xiangxu05/tensileMachine/Peel tension V4/伺服推杆/伺服电动缸 2700/877bbd0834424bce7f686309f9e86cf.jpg

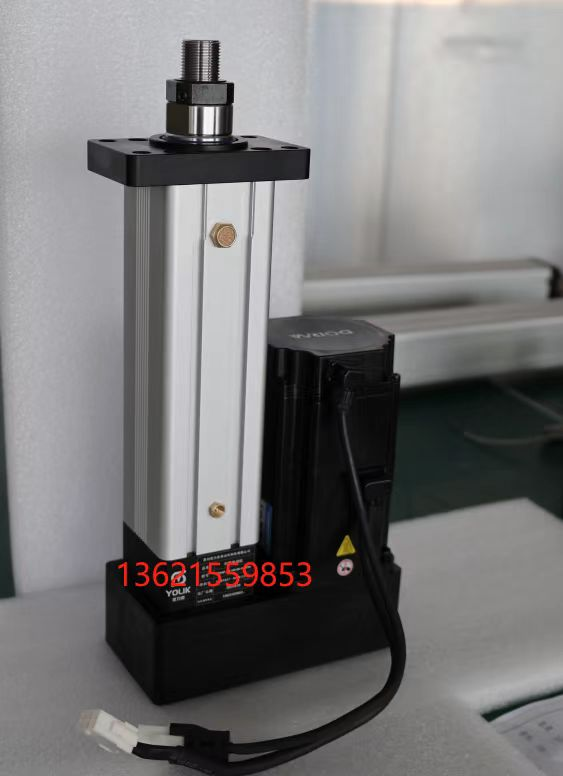
Peel tension V4/伺服推杆/伺服电动缸 2700/877bbd0834424bce7f686309f9e86cf.jpg
