xiangxu05/tensileMachine/Peel tension V4/伺服推杆/A伺服电缸 2850/苏州源鸿星伺服电缸报价-伺服电机-后法兰-YHX053-S150-项总10.18.pdf

苏州源鸿星自动化科技有限公司

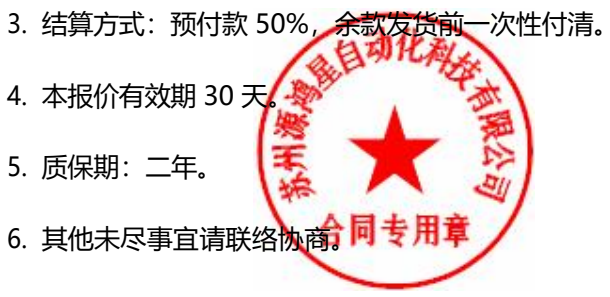
[picture p2: figure]
3. 结算方式：预付款 50%，余款发货前一次性付清。; 4. 本报价有效期 30 天。; 5. 质保期：二年。; 6. 其他未尽事宜请联络协商。

第 1 页 共 4页

## 苏州源鸿星自动化科技有限公司

## 报价单

### 客户名称：

### 联系人：项总

### 报价项目：伺服电缸

电话：15905903975

联系人：王远团 | 电话：18944282776

### 地址：江苏省苏州市吴中区

序号 | 产品名称 | 产品规格 | 单位 | 数量 | 单价 | 小计 | 品牌
2 | 电缸 | YHX053-S150-D05-B-M4C1-2-0400W-N1 | Pcs | 1 | 1500 | 1500 | 源鸿星
| 伺服电机 | 400W电机（带抱闸）+伺服驱动器 485通 讯 | PCS | 1 | 1350 | 1350 | 信捷
| 磁性开关 | DFSE-020-8C（赠送） | PCS | 2 | 0.00 | 0.00 | 元利富
技术参数:
配400W电机（带抱闸）+伺服驱动器，扭矩:1.27N.M., 额定转速:3000RPM, 减速比：1:1； 额定推力：100KG， 速度：0-250MM/S可调，有效行程：0-150mm(可调）;电机安装方式：折返，电缸安装方式：后法兰， 负载连接 方式：外螺纹， 丝杆规格：TBI1205
合计 RMB | 贰仟捌佰伍拾圆整 | 2850.00

### 1. 交货期：预付款到 5个工作日内交货（如需加急，需沟通确认）。

### 2. 价格条款：以上报价含13%增值税发票，运费由卖方承担。

苏州源鸿星自动化科技有限公司

第 2 页 共 4页

2023.10.18

## 请确认报价和参数是否满足您的需求，确认无误安排给您出尺寸图二维或者三维。

1 | 型号 | YHX053-S150-D05-B-M4C1-2-0400W-N1
2 | 外形图号 | | 见图纸
3 | 电机安装方式 | 折返
4 | 丝杆规格（mm） | TBI1205 | 滚珠丝杆/TBI
5 | 轴承 | 角接触轴承 推力滚子轴承 | 日本/NSK
6 | 有效行程（mm） | 0-150mm可调 | 注;外部紧固件采用镀镍螺钉和弹垫
7 | 最大行程（mm） | 155mm
8 | 额定推力（KN） | 100KG
9 | 额定速度（mm/s） | 0-250MM/S可调 | 速度可在（0-250mm/s）额定速度范围内 调节
10 | 重复定位精度(mm) | +/-0.02mm
11 | 电机型号 | MS6H-60CS30BZ1-20P4
12 | 驱动器型号 | DS5L1-20P4-PTA
13 | 电机额定功率（KW） | 400W
14 | 电机额定转速（rpm） | 3000RPM
15 | 减速比 | 1:1
16 | 内部防转机构 | 有 | 上银
17 | 限位开关 | 有 | 2 个极限（NPN 常开)
19 | 润滑方式 | 润滑油 | 标准锂基润滑脂 3 号，特殊环境请说明
20 | 电缸安装方式 | 后法兰
21 | 负载连接方式 | 外螺纹
