xiangxu05/tensileMachine/Peel tension V4/伺服推杆/伺服电动缸 2700/1cc9031d6b838c07ec88c5fcb92dcce.png

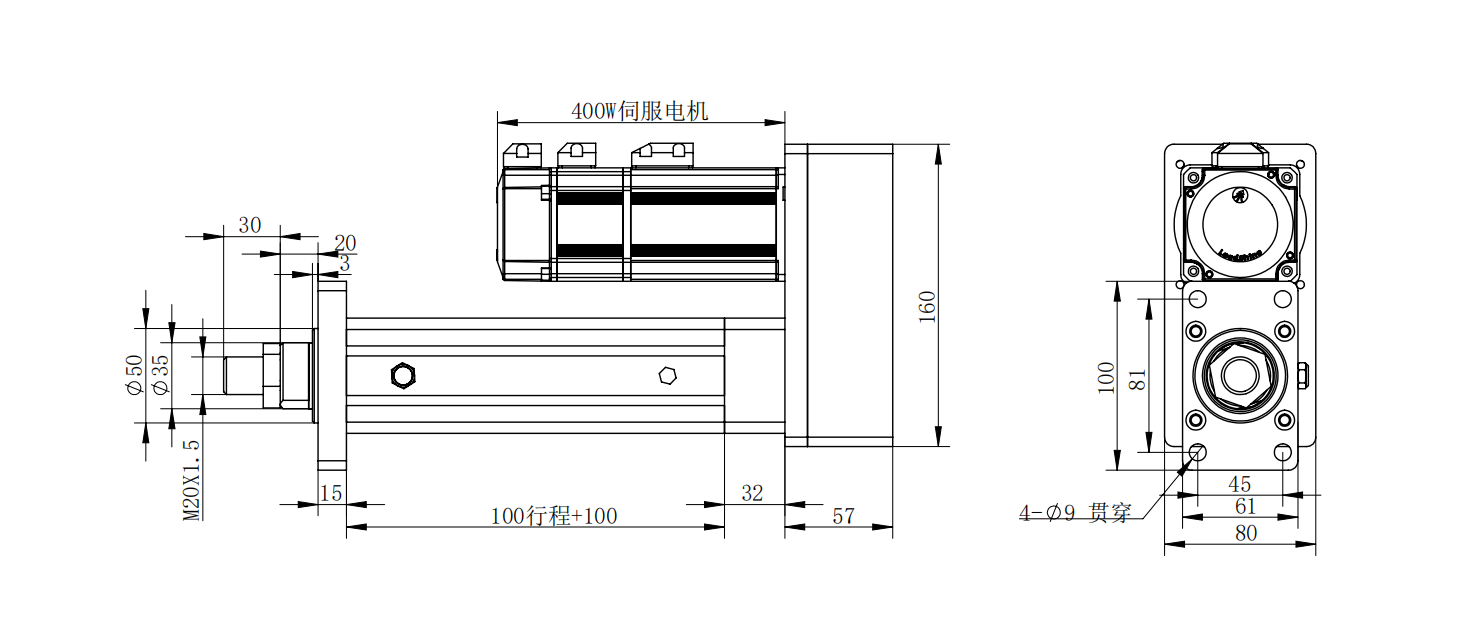
Peel tension V4/伺服推杆/伺服电动缸 2700/1cc9031d6b838c07ec88c5fcb92dcce.png
