xiangxu05/tensileMachine/Peel tension V4/电路板.SLDASM

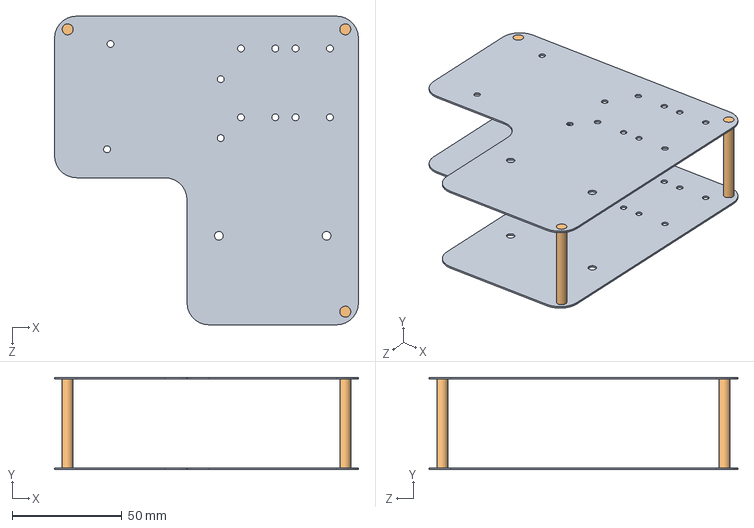
[picture p4: CAD file, 2024-04-22]
Peel tension V4/电路板.SLDASM
138.3 x 42.0 x 140.4 mm
电路板固定 x 2
柱子 x 3
