xiangxu05/tensileMachine/Peel tension V4/伺服推杆/道雨传动 3000/TDN55三维图/TDN55三维图/TDN55折返/TDN55折返行程700/负载连接端配件/BNC51-SA12T_K-R.SLDASM

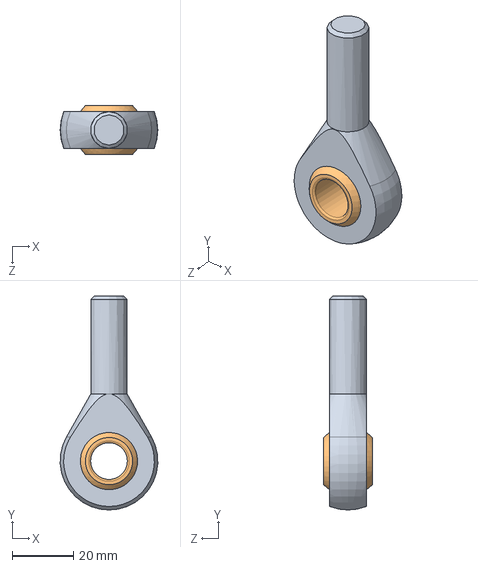
[picture p5: CAD file, 2024-04-22]
Peel tension V4/伺服推杆/道雨传动 3000/TDN55三维图/TDN55三维图/TDN55折返/TDN55折返行程700/负载连接端配件/BNC51-SA12T_K-R.SLDASM
31.9 x 70.0 x 16.0 mm
_BNC51-SA12T_K-R-001
_BNC51-SA12T_K-R-002
