xiangxu05/tensileMachine/Peel tension V4/伺服推杆.SLDASM

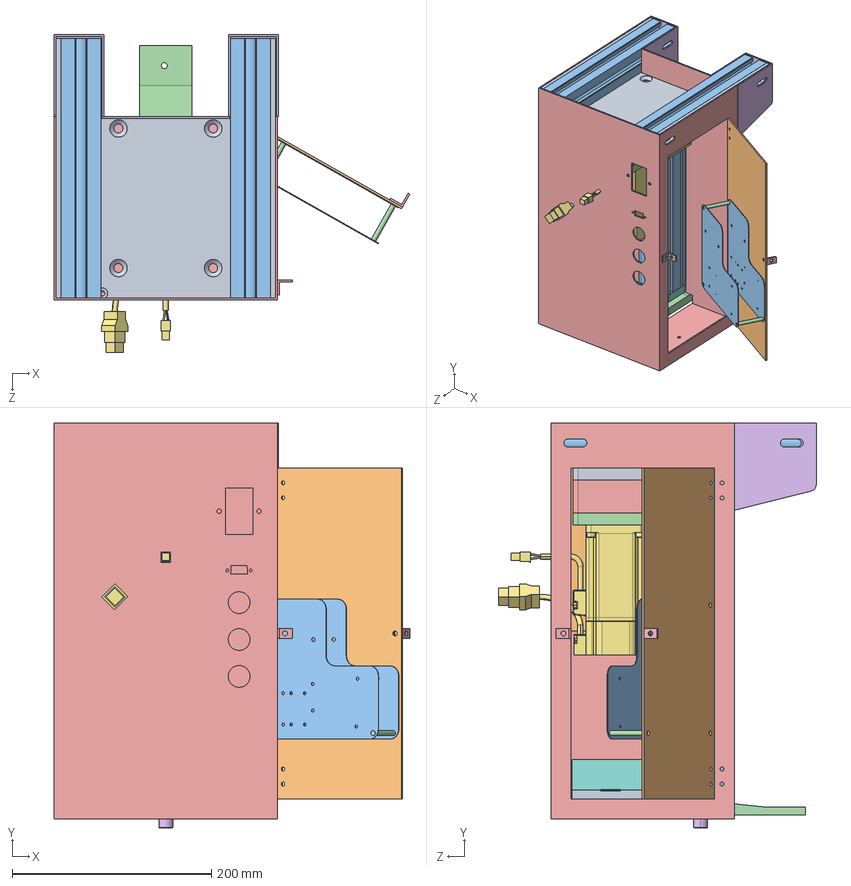
[picture p6: CAD file, 2024-04-22]
Peel tension V4/伺服推杆.SLDASM
356.7 x 406.1 x 318.4 mm
底板
53ZCZ.STEP
53GT.STEP
53LJB.STEP
53XT.STEP
M14X1.5.STEP
400W.STEP
53-QFL.STEP
53HFL.STEP
伺服驱动器
40x40x260 纵梁 x 2
顶板
外壳
外壳2 x 2
X505
down
top
外壳盖子
电路板固定 x 2
柱子 x 3
把手 x 2
