xiangxu05/tensileMachine/Peel tension V4/数模转换器固定/数模转换器固定.SLDASM

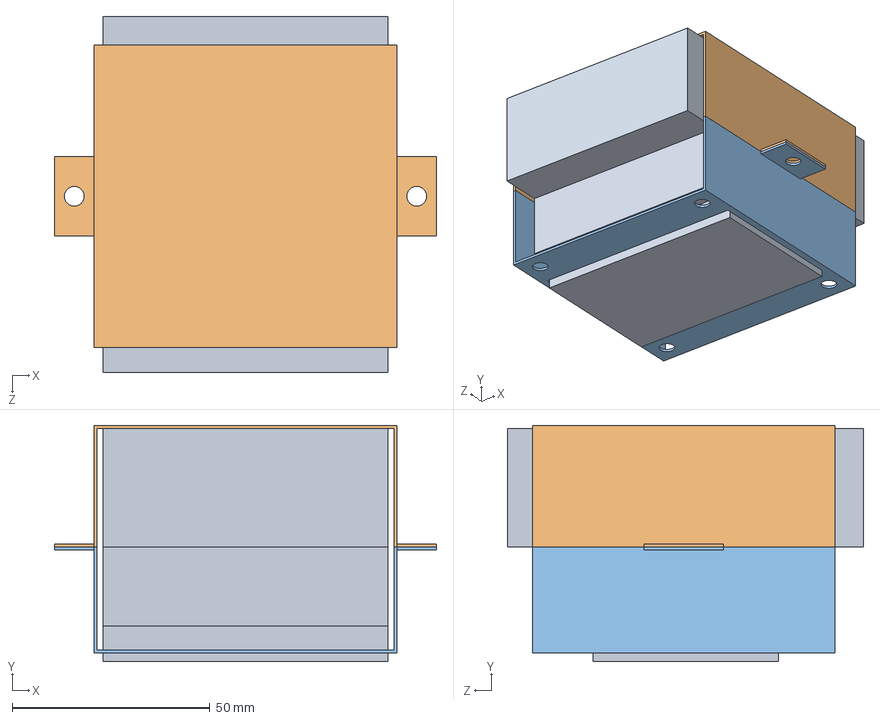
[picture p8: CAD file, 2024-04-22]
Peel tension V4/数模转换器固定/数模转换器固定.SLDASM
96.6 x 59.8 x 90.1 mm
X505
down
top
