xiangxu05/tensileMachine/Peel tension V4/外壳组装.SLDASM

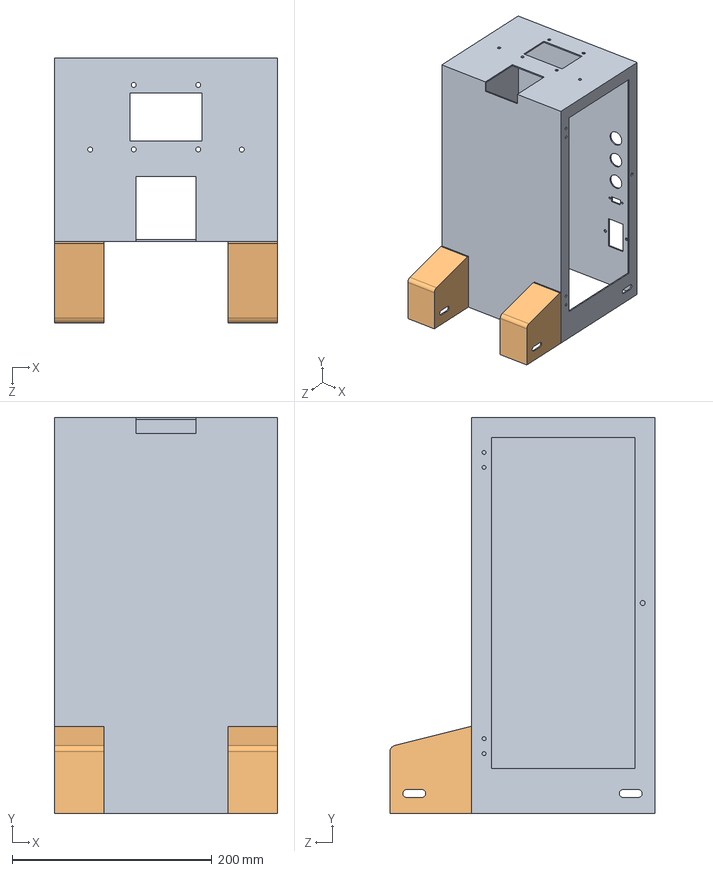
[picture p9: CAD file, 2024-04-22]
Peel tension V4/外壳组装.SLDASM
224.0 x 397.0 x 266.0 mm
外壳
外壳2 x 2
