xiangxu05/tensileMachine/Peel tension V4/装配体1.SLDASM

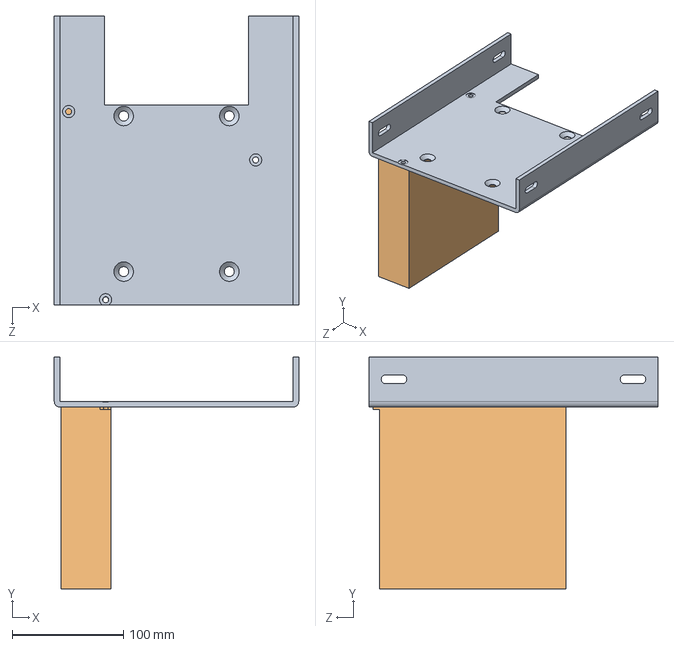
[picture p10: CAD file, 2024-04-22]
Peel tension V4/装配体1.SLDASM
220.0 x 208.6 x 260.0 mm
底板
伺服驱动器
