xiangxu05/tensileMachine/Peel tension V4/伺服推杆/道雨传动 3000/TDN55三维图/TDN55三维图/TDN55折返/TDN55折返行程100/推荐电机/信捷400W带刹车.STEP

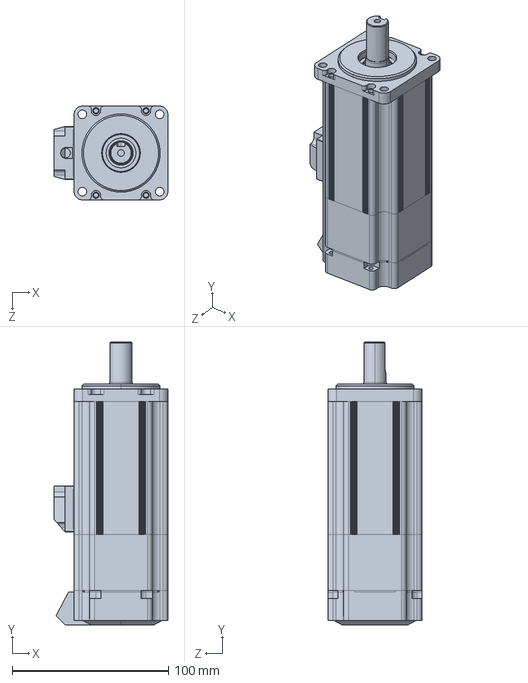
[picture p13: CAD file, 2024-04-22]
Peel tension V4/伺服推杆/道雨传动 3000/TDN55三维图/TDN55三维图/TDN55折返/TDN55折返行程100/推荐电机/信捷400W带刹车.STEP
72.8 x 181.0 x 60.0 mm
