xiangxu05/tensileMachine/Peel tension V4/伺服推杆/道雨传动 3000/TDN55三维图/TDN55三维图/TDN55折返/TDN55折返行程100/推荐行星减速机/PLF60A单级模型（14-30 50-3 4-5.5-70）.STEP

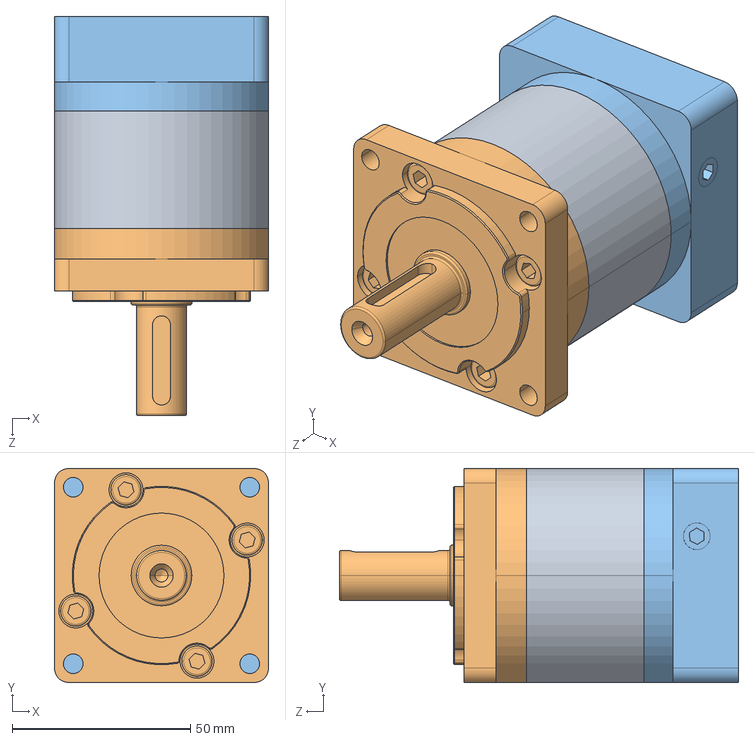
[picture p14: CAD file, 2024-04-22]
Peel tension V4/伺服推杆/道雨传动 3000/TDN55三维图/TDN55三维图/TDN55折返/TDN55折返行程100/推荐行星减速机/PLF60A单级模型（14-30 50-3 4-5.5-70）.STEP
60.0 x 60.0 x 112.0 mm
