xiangxu05/tensileMachine/Peel tension V4/伺服推杆/道雨传动 3000/TDN55三维图/TDN55三维图/TDN55折返/TDN55折返行程100/电缸安装配件/F-SI40TCM1_SE40耳轴铰座支架.stp

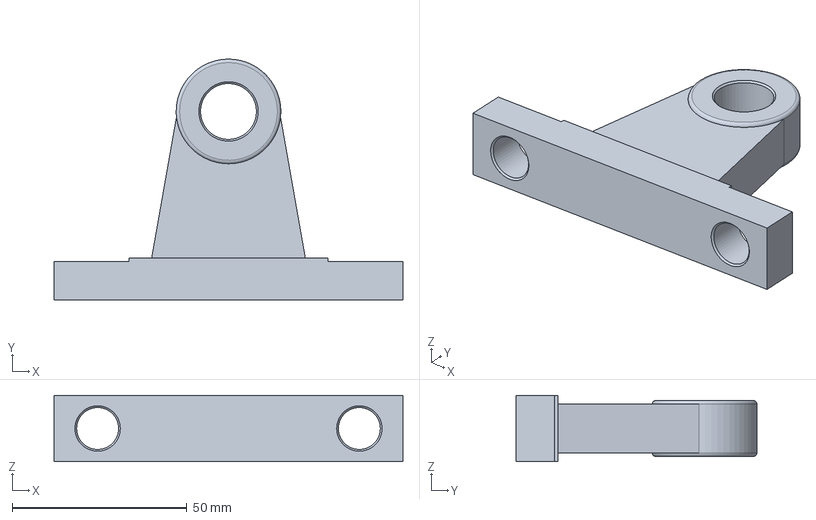
[picture p15: CAD file, 2024-04-22]
Peel tension V4/伺服推杆/道雨传动 3000/TDN55三维图/TDN55三维图/TDN55折返/TDN55折返行程100/电缸安装配件/F-SI40TCM1_SE40耳轴铰座支架.stp
100.0 x 69.0 x 19.0 mm
