xiangxu05/tensileMachine/Peel tension V4/伺服推杆/道雨传动 3000/TDN55三维图/TDN55三维图/TDN55折返/TDN55折返行程100/负载连接端配件/F-M12125Y型接头.stp

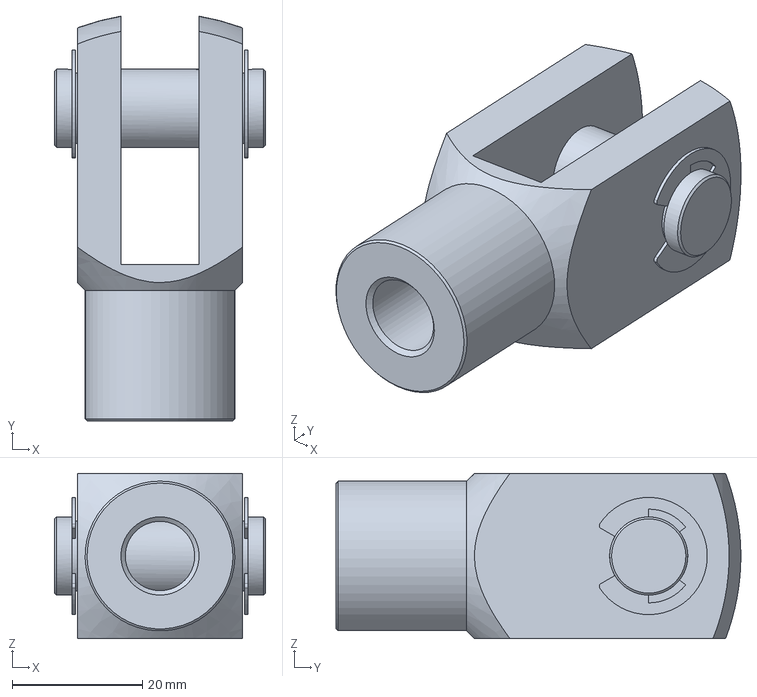
[picture p16: CAD file, 2024-04-22]
Peel tension V4/伺服推杆/道雨传动 3000/TDN55三维图/TDN55三维图/TDN55折返/TDN55折返行程100/负载连接端配件/F-M12125Y型接头.stp
32.4 x 62.1 x 25.4 mm
