xiangxu05/tensileMachine/Peel tension V4/伺服推杆/道雨传动 3000/TDN55三维图/TDN55三维图/TDN55折返/TDN55折返行程125/推荐电机/禾川400W带刹车.SLDPRT

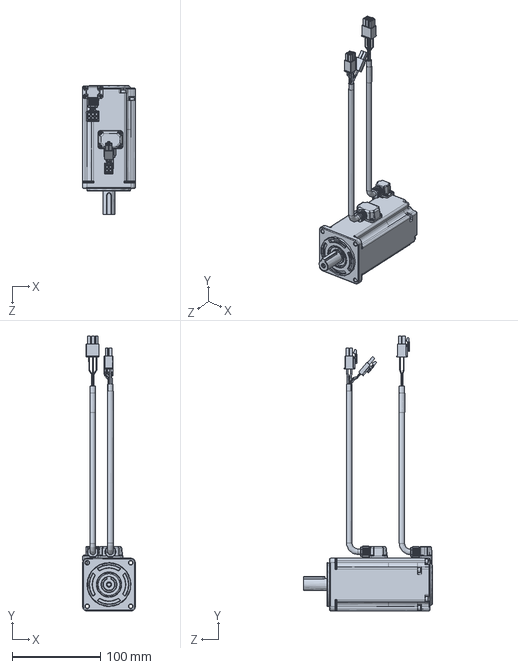
[picture p18: CAD file, 2024-04-22]
Peel tension V4/伺服推杆/道雨传动 3000/TDN55三维图/TDN55三维图/TDN55折返/TDN55折返行程125/推荐电机/禾川400W带刹车.SLDPRT
60.0 x 312.4 x 147.1 mm
