xiangxu05/tensileMachine/Peel tension V4/伺服推杆/道雨传动 3000/TDN55三维图/TDN55三维图/TDN55折返/TDN55折返行程125/电缸安装配件/F-SI40CR_SE斜耳铰座.stp

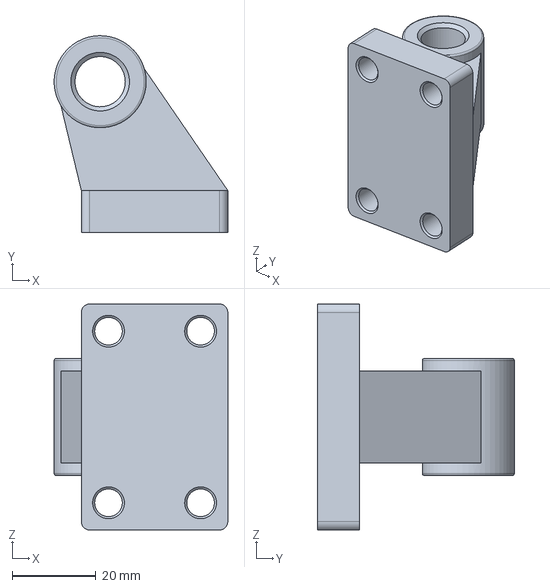
[picture p19: CAD file, 2024-04-22]
Peel tension V4/伺服推杆/道雨传动 3000/TDN55三维图/TDN55三维图/TDN55折返/TDN55折返行程125/电缸安装配件/F-SI40CR_SE斜耳铰座.stp
41.5 x 47.0 x 54.0 mm
