xiangxu05/tensileMachine/Peel tension V4/伺服推杆/道雨传动 3000/TDN55三维图/TDN55三维图/TDN55折返/TDN55折返行程125/负载连接端配件/F-M12X125I型接头.stp

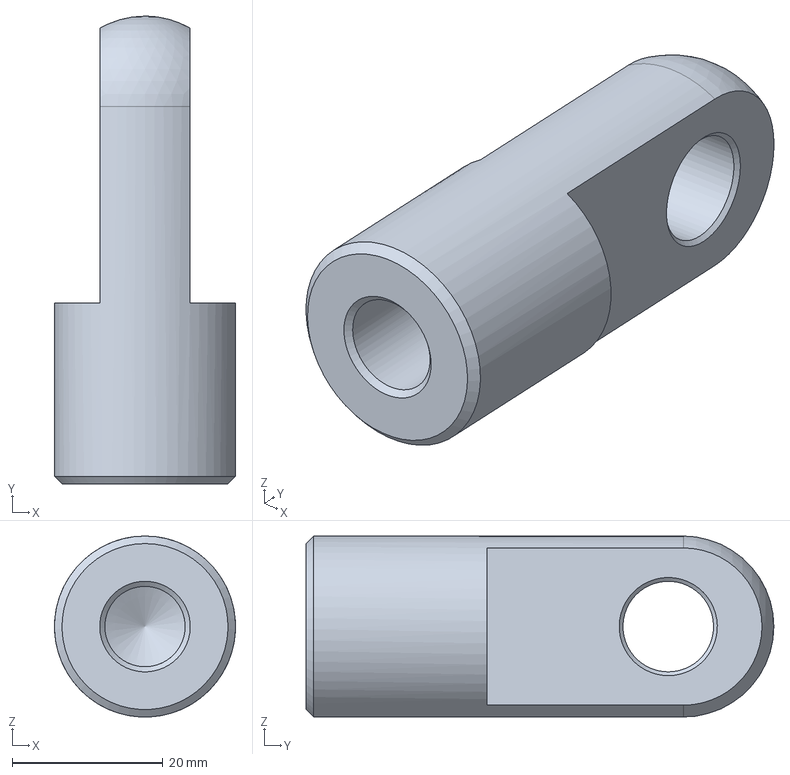
[picture p20: CAD file, 2024-04-22]
Peel tension V4/伺服推杆/道雨传动 3000/TDN55三维图/TDN55三维图/TDN55折返/TDN55折返行程125/负载连接端配件/F-M12X125I型接头.stp
24.0 x 62.0 x 24.0 mm
