xiangxu05/tensileMachine/Peel tension V4/伺服推杆/道雨传动 3000/TDN55三维图/TDN55三维图/TDN55折返/TDN55折返行程130/负载连接端配件/F-M12X125U鱼眼接头.stp

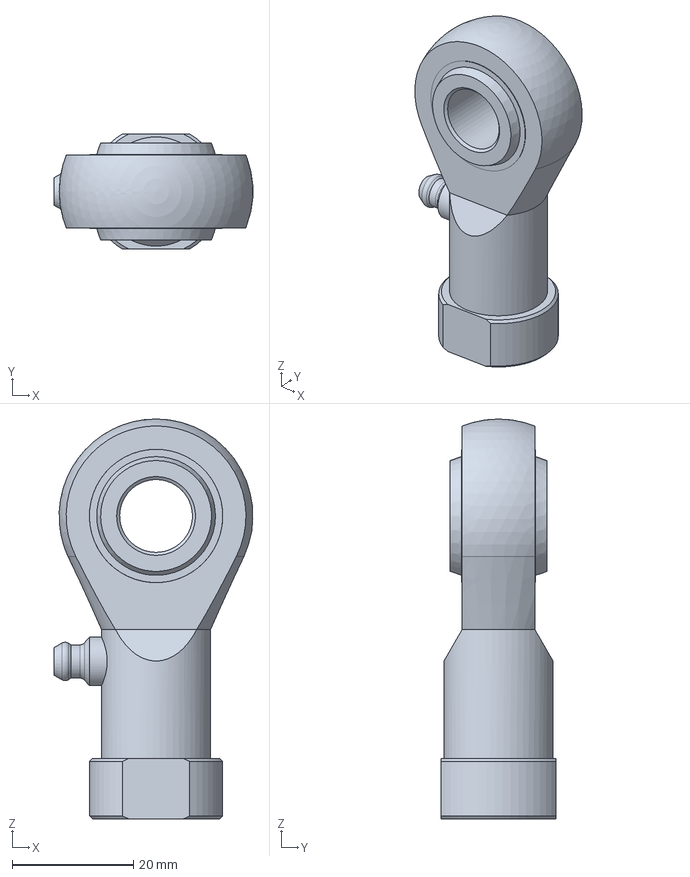
[picture p21: CAD file, 2024-04-22]
Peel tension V4/伺服推杆/道雨传动 3000/TDN55三维图/TDN55三维图/TDN55折返/TDN55折返行程130/负载连接端配件/F-M12X125U鱼眼接头.stp
32.8 x 19.0 x 66.0 mm
