xiangxu05/tensileMachine/Peel tension V4/伺服推杆/道雨传动 3000/TDN55三维图/TDN55三维图/TDN55折返/TDN55折返行程160/55缸折返基础版 - 160.STEP

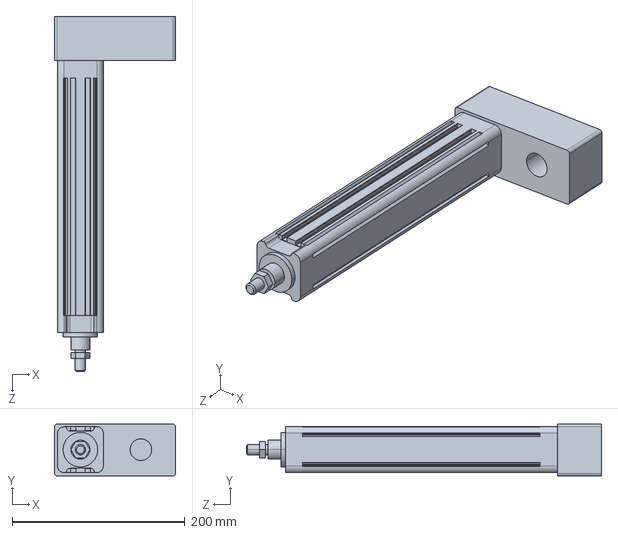
[picture p23: CAD file, 2024-04-22]
Peel tension V4/伺服推杆/道雨传动 3000/TDN55三维图/TDN55三维图/TDN55折返/TDN55折返行程160/55缸折返基础版 - 160.STEP
140.0 x 60.0 x 411.0 mm
