xiangxu05/tensileMachine/Peel tension V4/伺服推杆/道雨传动 3000/TDN55三维图/TDN55三维图/TDN55折返/TDN55折返行程160/电缸安装配件/F-SE40CB双耳铰座.stp

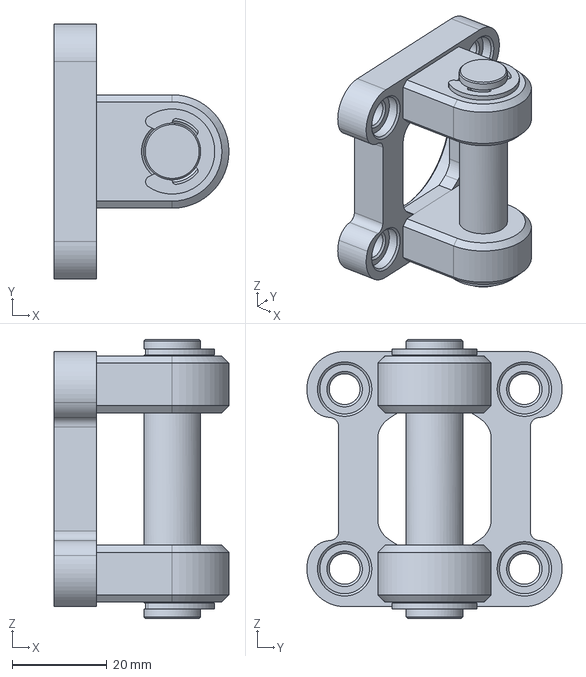
[picture p24: CAD file, 2024-04-22]
Peel tension V4/伺服推杆/道雨传动 3000/TDN55三维图/TDN55三维图/TDN55折返/TDN55折返行程160/电缸安装配件/F-SE40CB双耳铰座.stp
37.0 x 54.0 x 59.0 mm
