xiangxu05/tensileMachine/Peel tension V4/伺服推杆/道雨传动 3000/TDN55三维图/TDN55三维图/TDN55折返/TDN55折返行程170/电缸安装配件/F-SI40FTC_SE前耳轴铰座.stp

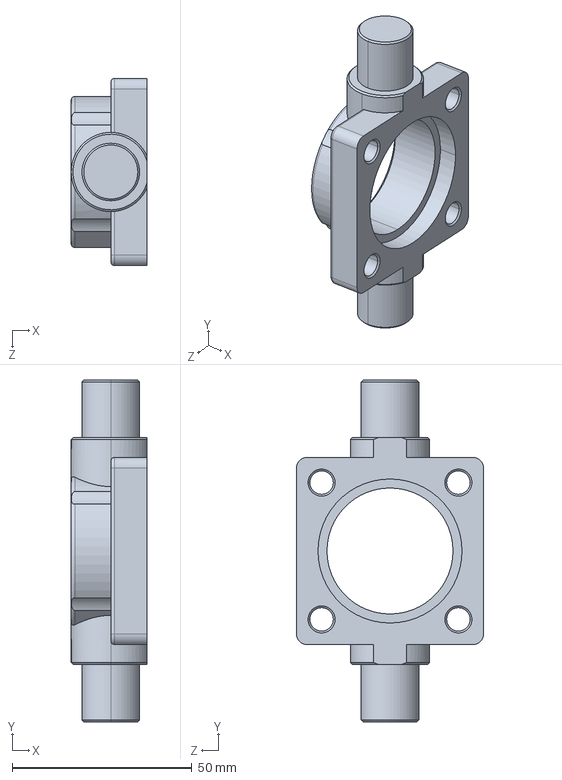
[picture p26: CAD file, 2024-04-22]
Peel tension V4/伺服推杆/道雨传动 3000/TDN55三维图/TDN55三维图/TDN55折返/TDN55折返行程170/电缸安装配件/F-SI40FTC_SE前耳轴铰座.stp
21.0 x 95.0 x 52.0 mm
