xiangxu05/tensileMachine/Peel tension V4/伺服推杆/道雨传动 3000/TDN55三维图/TDN55三维图/TDN55折返/TDN55折返行程200/电缸安装配件/F-SI40FA_1SE前法兰安装板.stp

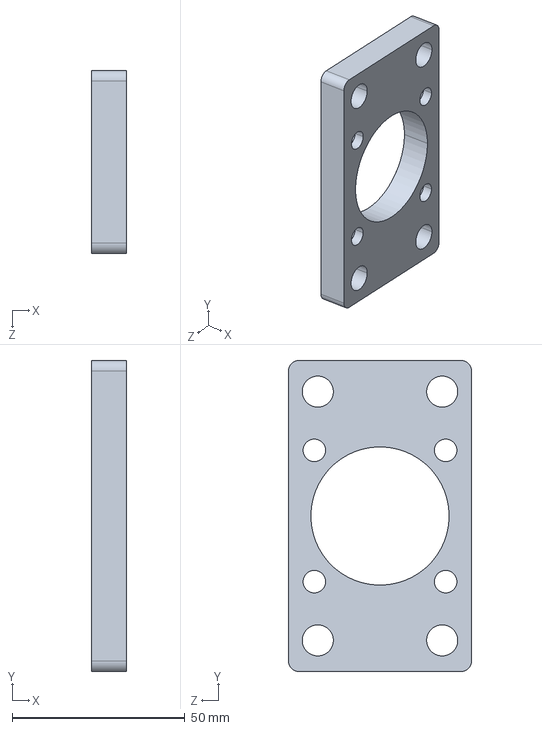
[picture p29: CAD file, 2024-04-22]
Peel tension V4/伺服推杆/道雨传动 3000/TDN55三维图/TDN55三维图/TDN55折返/TDN55折返行程200/电缸安装配件/F-SI40FA_1SE前法兰安装板.stp
10.0 x 90.0 x 53.0 mm
