xiangxu05/tensileMachine/Peel tension V4/伺服推杆/道雨传动 3000/TDN55三维图/TDN55三维图/TDN55折返/TDN55折返行程200/负载连接端配件/F-M12X125F浮动接头.stp

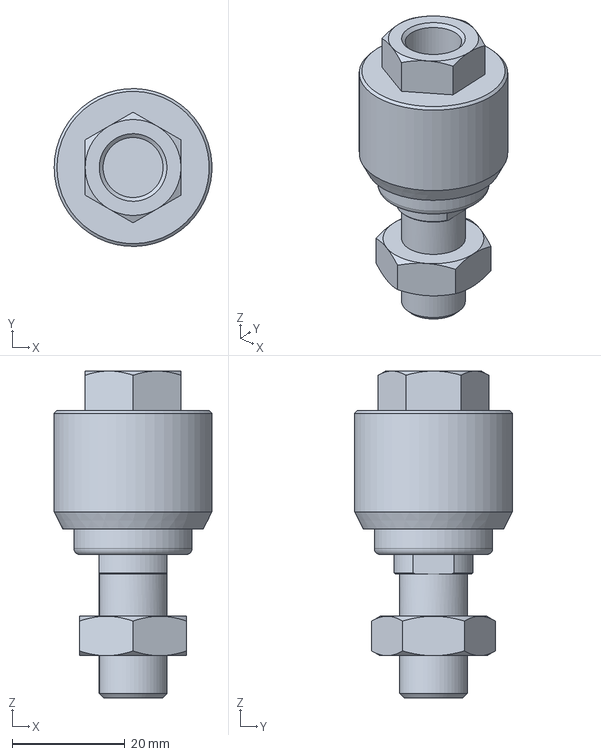
[picture p30: CAD file, 2024-04-22]
Peel tension V4/伺服推杆/道雨传动 3000/TDN55三维图/TDN55三维图/TDN55折返/TDN55折返行程200/负载连接端配件/F-M12X125F浮动接头.stp
28.0 x 28.0 x 58.0 mm
