xiangxu05/tensileMachine/Peel tension V4/伺服推杆/道雨传动 3000/TDN55三维图/TDN55三维图/TDN55折返/TDN55折返行程250/推荐电机/禾川400W不带刹车.stp

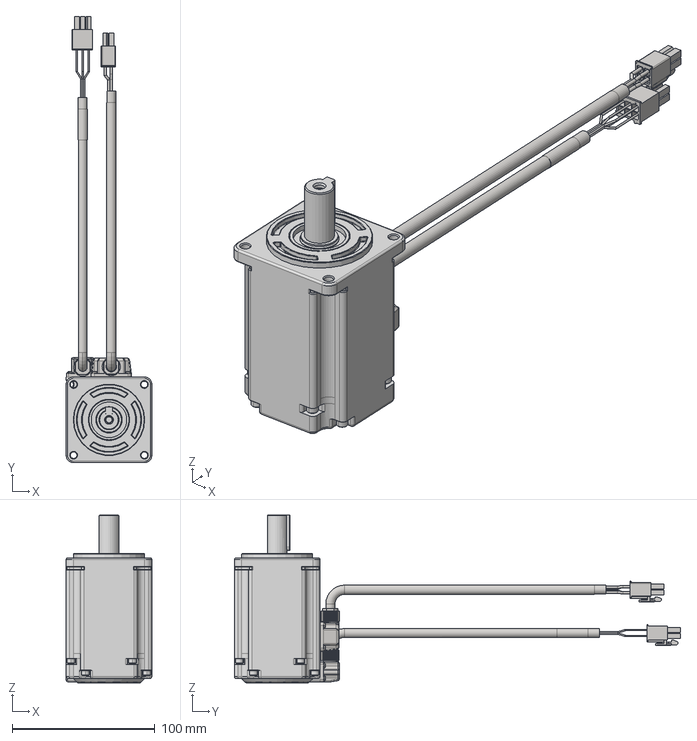
[picture p32: CAD file, 2024-04-22]
Peel tension V4/伺服推杆/道雨传动 3000/TDN55三维图/TDN55三维图/TDN55折返/TDN55折返行程250/推荐电机/禾川400W不带刹车.stp
60.0 x 312.5 x 117.6 mm
