xiangxu05/tensileMachine/Peel tension V4/伺服推杆/道雨传动 3000/TDN55三维图/TDN55三维图/TDN55折返/TDN55折返行程350/电缸安装配件/55缸底板安装固定板.STEP

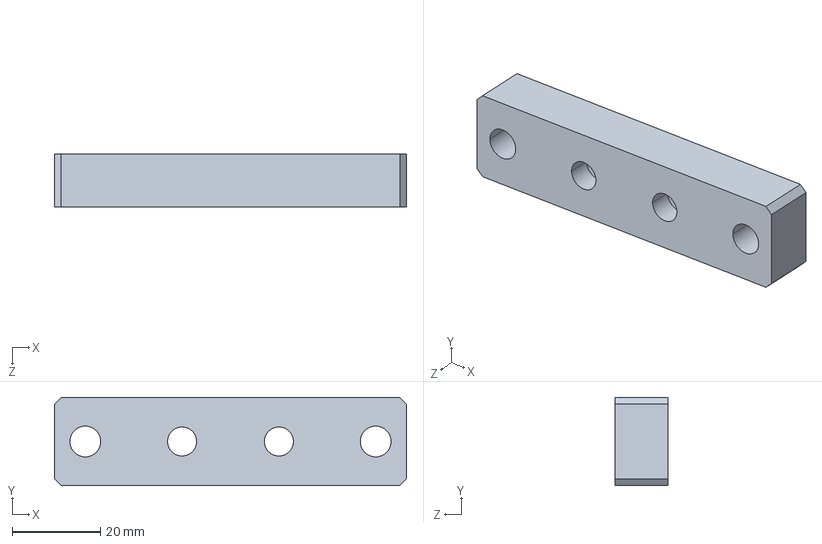
[picture p35: CAD file, 2024-04-22]
Peel tension V4/伺服推杆/道雨传动 3000/TDN55三维图/TDN55三维图/TDN55折返/TDN55折返行程350/电缸安装配件/55缸底板安装固定板.STEP
80.0 x 20.0 x 12.0 mm
