xiangxu05/tensileMachine/Peel tension V4/伺服推杆/道雨传动 3000/TDN55三维图/TDN55三维图/TDN55折返/TDN55折返行程40/55缸折返基础版 - 40.STEP

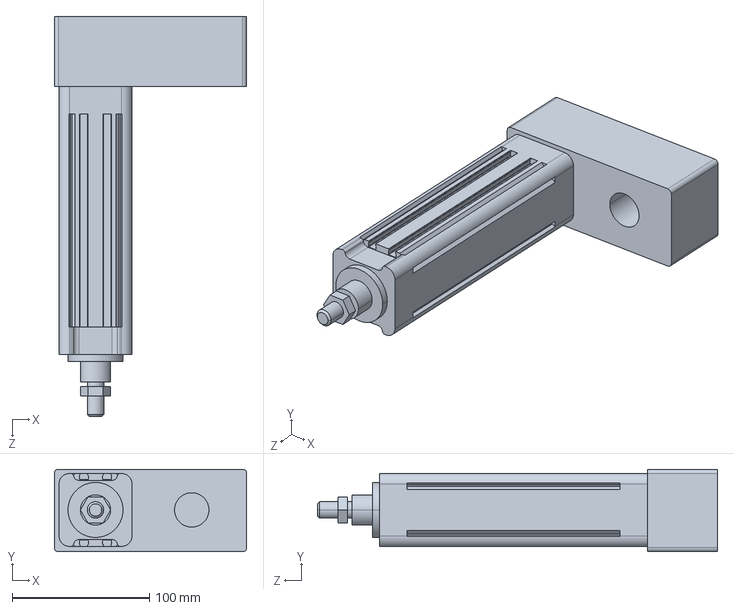
[picture p36: CAD file, 2024-04-22]
Peel tension V4/伺服推杆/道雨传动 3000/TDN55三维图/TDN55三维图/TDN55折返/TDN55折返行程40/55缸折返基础版 - 40.STEP
140.0 x 60.0 x 291.0 mm
