xiangxu05/tensileMachine/Peel tension V4/伺服推杆/道雨传动 3000/TDN55三维图/TDN55三维图/TDN55折返/TDN55折返行程450/55缸折返基础版 - 450.STEP

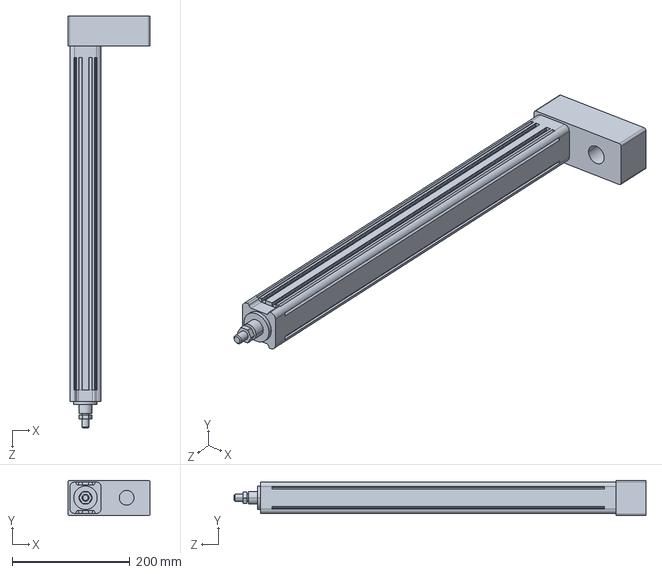
[picture p38: CAD file, 2024-04-22]
Peel tension V4/伺服推杆/道雨传动 3000/TDN55三维图/TDN55三维图/TDN55折返/TDN55折返行程450/55缸折返基础版 - 450.STEP
140.0 x 60.0 x 701.0 mm
