xiangxu05/tensileMachine/Peel tension V4/伺服推杆/道雨传动 3000/TDN55三维图/TDN55三维图/TDN55折返/TDN55折返行程500/电缸安装配件/55折返后法兰安装板.STEP

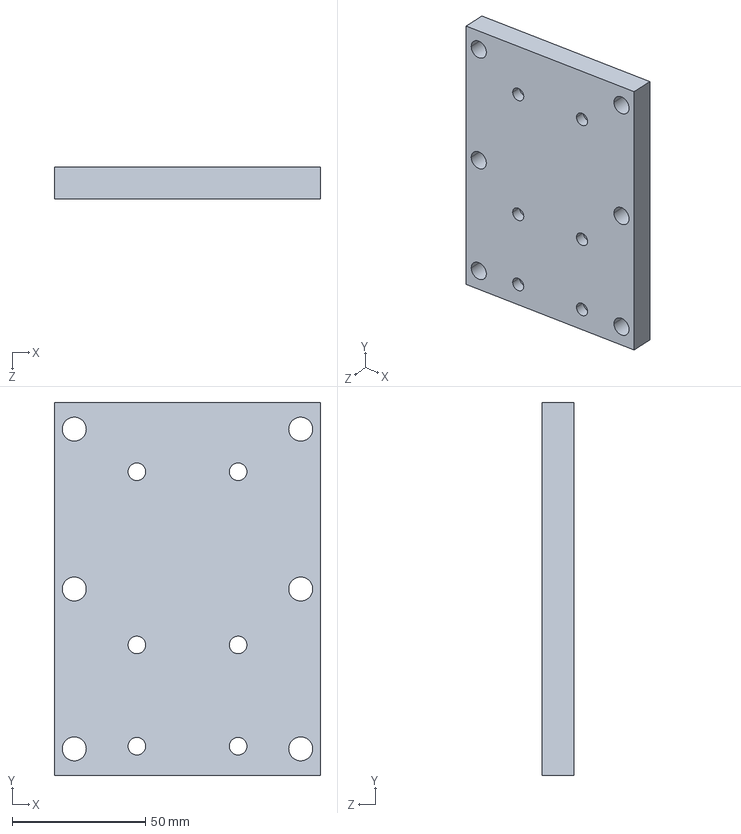
[picture p42: CAD file, 2024-04-22]
Peel tension V4/伺服推杆/道雨传动 3000/TDN55三维图/TDN55三维图/TDN55折返/TDN55折返行程500/电缸安装配件/55折返后法兰安装板.STEP
100.0 x 140.0 x 12.0 mm
