xiangxu05/tensileMachine/Peel tension V4/伺服推杆/道雨传动 3000/TDN55三维图/TDN55三维图/TDN55直连/55缸双导杆三维/55缸双导杆前法兰型固定板.SLDPRT

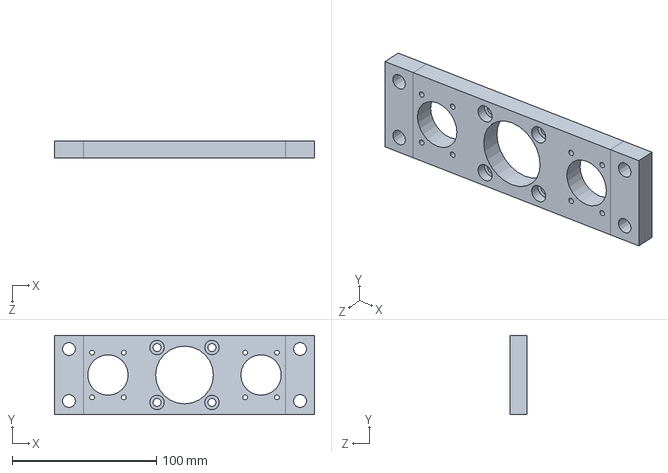
[picture p48: CAD file, 2024-04-22]
Peel tension V4/伺服推杆/道雨传动 3000/TDN55三维图/TDN55三维图/TDN55直连/55缸双导杆三维/55缸双导杆前法兰型固定板.SLDPRT
180.0 x 55.0 x 12.0 mm
