xiangxu05/tensileMachine/Peel tension V4/伺服推杆/道雨传动 3000/TDN55三维图/TDN55三维图/TDN55直连/TDN55直连行程150/55缸直连基础版-150.STEP

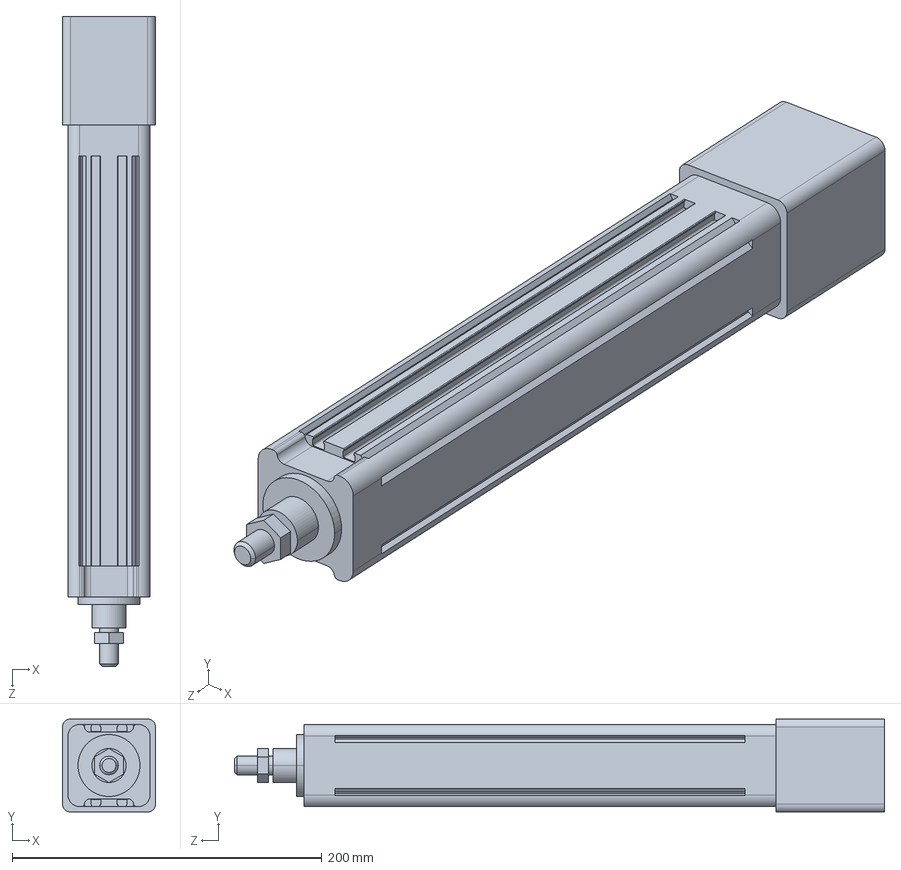
[picture p51: CAD file, 2024-04-22]
Peel tension V4/伺服推杆/道雨传动 3000/TDN55三维图/TDN55三维图/TDN55直连/TDN55直连行程150/55缸直连基础版-150.STEP
60.0 x 60.0 x 420.0 mm
