xiangxu05/tensileMachine/Peel tension V4/伺服推杆/道雨传动 3000/TDN55三维图/TDN55三维图/TDN55直连/TDN55直连行程200/55缸直连基础版-200.STEP

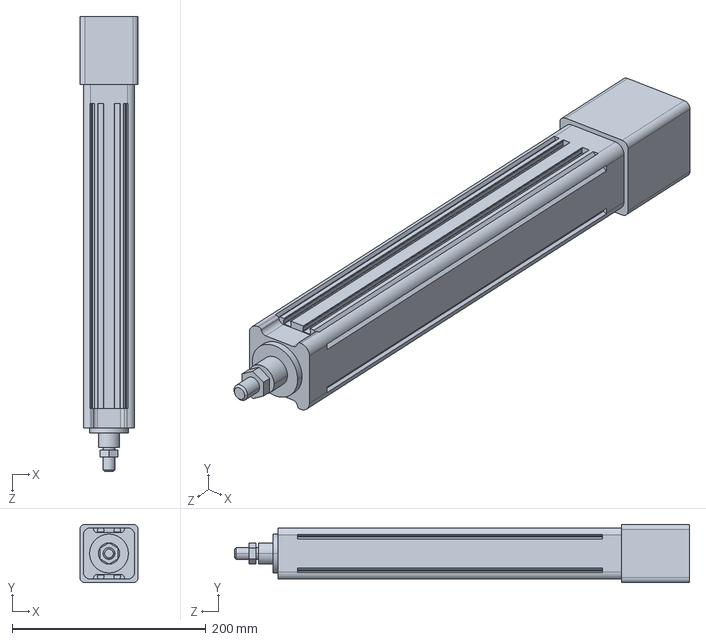
[picture p53: CAD file, 2024-04-22]
Peel tension V4/伺服推杆/道雨传动 3000/TDN55三维图/TDN55三维图/TDN55直连/TDN55直连行程200/55缸直连基础版-200.STEP
60.0 x 60.0 x 470.0 mm
