xiangxu05/tensileMachine/(list of files, cad)

Other CAD files:
Peel tension V4/伺服推杆/A伺服电缸 2850/53LJB.STEP.SLDPRT
Peel tension V4/伺服推杆/道雨传动 3000/TDN55三维图/TDN55三维图/TDN55折返/TDN55折返行程130/55缸折返基础版 - 130.STEP
Peel tension V4/伺服推杆/道雨传动 3000/TDN55三维图/TDN55三维图/TDN55折返/TDN55折返行程150/推荐电机/禾川400W带刹车.SLDPRT
Peel tension V4/伺服推杆/道雨传动 3000/TDN55三维图/TDN55三维图/TDN55折返/TDN55折返行程350/推荐电机/禾川400W带刹车.SLDPRT
Peel tension V4/伺服推杆/道雨传动 3000/TDN55三维图/TDN55三维图/TDN55折返/TDN55折返行程40/电缸安装配件/F-SI40FA_1SE前法兰安装板.stp
Peel tension V4/伺服推杆/道雨传动 3000/TDN55三维图/TDN55三维图/TDN55直连/TDN55直连行程200/推荐电机/禾川400W带刹车.SLDPRT
Peel tension V4/40x40x160 横梁.SLDPRT
Peel tension V4/40x40x260 纵梁.SLDPRT
Peel tension V4/万向轮.SLDPRT
Peel tension V4/伺服推杆/A伺服电缸 2850/400W.STEP.SLDPRT
Peel tension V4/伺服推杆/A伺服电缸 2850/53-QFL.STEP.SLDPRT
Peel tension V4/伺服推杆/A伺服电缸 2850/53GT.STEP.SLDPRT
Peel tension V4/伺服推杆/A伺服电缸 2850/53HFL.STEP.SLDPRT
Peel tension V4/伺服推杆/A伺服电缸 2850/53XT.STEP.SLDPRT
Peel tension V4/伺服推杆/A伺服电缸 2850/53ZCZ.STEP.SLDPRT
Peel tension V4/伺服推杆/A伺服电缸 2850/DS5L1-20P4-PTA-外观图-210910.dwg
Peel tension V4/伺服推杆/A伺服电缸 2850/M14X1.5.STEP.SLDPRT
Peel tension V4/伺服推杆/A伺服电缸 2850/YHX053-S150-D05-B-M4-C1-2-0400W-N1.STEP
Peel tension V4/伺服推杆/道雨传动 3000/TDN55三维图/TDN55三维图/TDN55折返/TDN55折返行程100/55缸折返基础版 - 100.SLDPRT
Peel tension V4/伺服推杆/道雨传动 3000/TDN55三维图/TDN55三维图/TDN55折返/TDN55折返行程100/推荐电机/60步进电机.SLDPRT
Peel tension V4/伺服推杆/道雨传动 3000/TDN55三维图/TDN55三维图/TDN55折返/TDN55折返行程100/推荐电机/信捷400W不带刹车.SLDPRT
Peel tension V4/伺服推杆/道雨传动 3000/TDN55三维图/TDN55三维图/TDN55折返/TDN55折返行程100/推荐电机/信捷400W带刹车.SLDPRT
Peel tension V4/伺服推杆/道雨传动 3000/TDN55三维图/TDN55三维图/TDN55折返/TDN55折返行程100/推荐电机/禾川400W不带刹车.SLDPRT
Peel tension V4/伺服推杆/道雨传动 3000/TDN55三维图/TDN55三维图/TDN55折返/TDN55折返行程100/推荐行星减速机/PLF60A单级模型（14-30 50-3 4-5.5-70）.SLDPRT
Peel tension V4/伺服推杆/道雨传动 3000/TDN55三维图/TDN55三维图/TDN55折返/TDN55折返行程100/电缸安装配件/2214899_DAMT-V1-40-A中间铰座.SLDPRT
Peel tension V4/伺服推杆/道雨传动 3000/TDN55三维图/TDN55三维图/TDN55折返/TDN55折返行程100/电缸安装配件/2214899_DAMT-V1-40-A中间铰座.STEP
Peel tension V4/伺服推杆/道雨传动 3000/TDN55三维图/TDN55三维图/TDN55折返/TDN55折返行程100/电缸安装配件/55折返后法兰安装板.SLDPRT
Peel tension V4/伺服推杆/道雨传动 3000/TDN55三维图/TDN55三维图/TDN55折返/TDN55折返行程100/电缸安装配件/55缸底板安装固定板.SLDPRT
Peel tension V4/伺服推杆/道雨传动 3000/TDN55三维图/TDN55三维图/TDN55折返/TDN55折返行程100/电缸安装配件/F-SE40CA单耳铰座.SLDPRT
Peel tension V4/伺服推杆/道雨传动 3000/TDN55三维图/TDN55三维图/TDN55折返/TDN55折返行程100/电缸安装配件/F-SE40CB双耳铰座.SLDPRT
Peel tension V4/伺服推杆/道雨传动 3000/TDN55三维图/TDN55三维图/TDN55折返/TDN55折返行程100/电缸安装配件/F-SI40CR_SE斜耳铰座.SLDPRT
Peel tension V4/伺服推杆/道雨传动 3000/TDN55三维图/TDN55三维图/TDN55折返/TDN55折返行程100/电缸安装配件/F-SI40FA_1SE前法兰安装板.SLDPRT
Peel tension V4/伺服推杆/道雨传动 3000/TDN55三维图/TDN55三维图/TDN55折返/TDN55折返行程100/电缸安装配件/F-SI40FTC_SE前耳轴铰座.SLDPRT
Peel tension V4/伺服推杆/道雨传动 3000/TDN55三维图/TDN55三维图/TDN55折返/TDN55折返行程100/电缸安装配件/F-SI40TCM1_SE40耳轴铰座支架.SLDPRT
Peel tension V4/伺服推杆/道雨传动 3000/TDN55三维图/TDN55三维图/TDN55折返/TDN55折返行程100/负载连接端配件/F-M12125Y型接头.SLDPRT
Peel tension V4/伺服推杆/道雨传动 3000/TDN55三维图/TDN55三维图/TDN55折返/TDN55折返行程100/负载连接端配件/F-M12X125F浮动接头.SLDPRT
Peel tension V4/伺服推杆/道雨传动 3000/TDN55三维图/TDN55三维图/TDN55折返/TDN55折返行程100/负载连接端配件/F-M12X125I型接头.SLDPRT
Peel tension V4/伺服推杆/道雨传动 3000/TDN55三维图/TDN55三维图/TDN55折返/TDN55折返行程100/负载连接端配件/F-M12X125U鱼眼接头.SLDPRT
Peel tension V4/伺服推杆/道雨传动 3000/TDN55三维图/TDN55三维图/TDN55折返/TDN55折返行程125/55缸折返基础版 - 125.SLDPRT
Peel tension V4/伺服推杆/道雨传动 3000/TDN55三维图/TDN55三维图/TDN55折返/TDN55折返行程125/推荐电机/60步进电机.SLDPRT
Peel tension V4/伺服推杆/道雨传动 3000/TDN55三维图/TDN55三维图/TDN55折返/TDN55折返行程125/推荐电机/信捷400W不带刹车.SLDPRT
Peel tension V4/伺服推杆/道雨传动 3000/TDN55三维图/TDN55三维图/TDN55折返/TDN55折返行程125/推荐电机/信捷400W带刹车.SLDPRT
Peel tension V4/伺服推杆/道雨传动 3000/TDN55三维图/TDN55三维图/TDN55折返/TDN55折返行程125/推荐电机/禾川400W不带刹车.SLDPRT
Peel tension V4/伺服推杆/道雨传动 3000/TDN55三维图/TDN55三维图/TDN55折返/TDN55折返行程125/推荐行星减速机/PLF60A单级模型（14-30 50-3 4-5.5-70）.SLDPRT
Peel tension V4/伺服推杆/道雨传动 3000/TDN55三维图/TDN55三维图/TDN55折返/TDN55折返行程125/电缸安装配件/2214899_DAMT-V1-40-A中间铰座.SLDPRT
Peel tension V4/伺服推杆/道雨传动 3000/TDN55三维图/TDN55三维图/TDN55折返/TDN55折返行程125/电缸安装配件/2214899_DAMT-V1-40-A中间铰座.STEP
Peel tension V4/伺服推杆/道雨传动 3000/TDN55三维图/TDN55三维图/TDN55折返/TDN55折返行程125/电缸安装配件/55折返后法兰安装板.SLDPRT
Peel tension V4/伺服推杆/道雨传动 3000/TDN55三维图/TDN55三维图/TDN55折返/TDN55折返行程125/电缸安装配件/55缸底板安装固定板.SLDPRT
Peel tension V4/伺服推杆/道雨传动 3000/TDN55三维图/TDN55三维图/TDN55折返/TDN55折返行程125/电缸安装配件/F-SE40CA单耳铰座.SLDPRT
Peel tension V4/伺服推杆/道雨传动 3000/TDN55三维图/TDN55三维图/TDN55折返/TDN55折返行程125/电缸安装配件/F-SE40CB双耳铰座.SLDPRT
Peel tension V4/伺服推杆/道雨传动 3000/TDN55三维图/TDN55三维图/TDN55折返/TDN55折返行程125/电缸安装配件/F-SI40CR_SE斜耳铰座.SLDPRT
Peel tension V4/伺服推杆/道雨传动 3000/TDN55三维图/TDN55三维图/TDN55折返/TDN55折返行程125/电缸安装配件/F-SI40FA_1SE前法兰安装板.SLDPRT
Peel tension V4/伺服推杆/道雨传动 3000/TDN55三维图/TDN55三维图/TDN55折返/TDN55折返行程125/电缸安装配件/F-SI40FTC_SE前耳轴铰座.SLDPRT
Peel tension V4/伺服推杆/道雨传动 3000/TDN55三维图/TDN55三维图/TDN55折返/TDN55折返行程125/电缸安装配件/F-SI40TCM1_SE40耳轴铰座支架.SLDPRT
Peel tension V4/伺服推杆/道雨传动 3000/TDN55三维图/TDN55三维图/TDN55折返/TDN55折返行程125/负载连接端配件/F-M12125Y型接头.SLDPRT
Peel tension V4/伺服推杆/道雨传动 3000/TDN55三维图/TDN55三维图/TDN55折返/TDN55折返行程125/负载连接端配件/F-M12X125F浮动接头.SLDPRT
Peel tension V4/伺服推杆/道雨传动 3000/TDN55三维图/TDN55三维图/TDN55折返/TDN55折返行程125/负载连接端配件/F-M12X125I型接头.SLDPRT
Peel tension V4/伺服推杆/道雨传动 3000/TDN55三维图/TDN55三维图/TDN55折返/TDN55折返行程125/负载连接端配件/F-M12X125U鱼眼接头.SLDPRT
Peel tension V4/伺服推杆/道雨传动 3000/TDN55三维图/TDN55三维图/TDN55折返/TDN55折返行程130/55缸折返基础版 - 130.SLDPRT
Peel tension V4/伺服推杆/道雨传动 3000/TDN55三维图/TDN55三维图/TDN55折返/TDN55折返行程130/推荐电机/60步进电机.SLDPRT
Peel tension V4/伺服推杆/道雨传动 3000/TDN55三维图/TDN55三维图/TDN55折返/TDN55折返行程130/推荐电机/信捷400W不带刹车.SLDPRT
Peel tension V4/伺服推杆/道雨传动 3000/TDN55三维图/TDN55三维图/TDN55折返/TDN55折返行程130/推荐电机/信捷400W带刹车.SLDPRT
Peel tension V4/伺服推杆/道雨传动 3000/TDN55三维图/TDN55三维图/TDN55折返/TDN55折返行程130/推荐电机/禾川400W不带刹车.SLDPRT
Peel tension V4/伺服推杆/道雨传动 3000/TDN55三维图/TDN55三维图/TDN55折返/TDN55折返行程130/推荐行星减速机/PLF60A单级模型（14-30 50-3 4-5.5-70）.SLDPRT
Peel tension V4/伺服推杆/道雨传动 3000/TDN55三维图/TDN55三维图/TDN55折返/TDN55折返行程130/电缸安装配件/2214899_DAMT-V1-40-A中间铰座.SLDPRT
Peel tension V4/伺服推杆/道雨传动 3000/TDN55三维图/TDN55三维图/TDN55折返/TDN55折返行程130/电缸安装配件/2214899_DAMT-V1-40-A中间铰座.STEP
Peel tension V4/伺服推杆/道雨传动 3000/TDN55三维图/TDN55三维图/TDN55折返/TDN55折返行程130/电缸安装配件/55折返后法兰安装板.SLDPRT
Peel tension V4/伺服推杆/道雨传动 3000/TDN55三维图/TDN55三维图/TDN55折返/TDN55折返行程130/电缸安装配件/55缸底板安装固定板.SLDPRT
Peel tension V4/伺服推杆/道雨传动 3000/TDN55三维图/TDN55三维图/TDN55折返/TDN55折返行程130/电缸安装配件/F-SE40CA单耳铰座.SLDPRT
Peel tension V4/伺服推杆/道雨传动 3000/TDN55三维图/TDN55三维图/TDN55折返/TDN55折返行程130/电缸安装配件/F-SE40CB双耳铰座.SLDPRT
Peel tension V4/伺服推杆/道雨传动 3000/TDN55三维图/TDN55三维图/TDN55折返/TDN55折返行程130/电缸安装配件/F-SI40CR_SE斜耳铰座.SLDPRT
Peel tension V4/伺服推杆/道雨传动 3000/TDN55三维图/TDN55三维图/TDN55折返/TDN55折返行程130/电缸安装配件/F-SI40FA_1SE前法兰安装板.SLDPRT
Peel tension V4/伺服推杆/道雨传动 3000/TDN55三维图/TDN55三维图/TDN55折返/TDN55折返行程130/电缸安装配件/F-SI40FTC_SE前耳轴铰座.SLDPRT
Peel tension V4/伺服推杆/道雨传动 3000/TDN55三维图/TDN55三维图/TDN55折返/TDN55折返行程130/电缸安装配件/F-SI40TCM1_SE40耳轴铰座支架.SLDPRT
Peel tension V4/伺服推杆/道雨传动 3000/TDN55三维图/TDN55三维图/TDN55折返/TDN55折返行程130/负载连接端配件/F-M12125Y型接头.SLDPRT
Peel tension V4/伺服推杆/道雨传动 3000/TDN55三维图/TDN55三维图/TDN55折返/TDN55折返行程130/负载连接端配件/F-M12X125F浮动接头.SLDPRT
Peel tension V4/伺服推杆/道雨传动 3000/TDN55三维图/TDN55三维图/TDN55折返/TDN55折返行程130/负载连接端配件/F-M12X125I型接头.SLDPRT
Peel tension V4/伺服推杆/道雨传动 3000/TDN55三维图/TDN55三维图/TDN55折返/TDN55折返行程130/负载连接端配件/F-M12X125U鱼眼接头.SLDPRT
Peel tension V4/伺服推杆/道雨传动 3000/TDN55三维图/TDN55三维图/TDN55折返/TDN55折返行程150/55缸折返基础版 - 150.SLDPRT
Peel tension V4/伺服推杆/道雨传动 3000/TDN55三维图/TDN55三维图/TDN55折返/TDN55折返行程150/推荐电机/60步进电机.SLDPRT
Peel tension V4/伺服推杆/道雨传动 3000/TDN55三维图/TDN55三维图/TDN55折返/TDN55折返行程150/推荐电机/信捷400W不带刹车.SLDPRT
Peel tension V4/伺服推杆/道雨传动 3000/TDN55三维图/TDN55三维图/TDN55折返/TDN55折返行程150/推荐电机/信捷400W带刹车.SLDPRT
Peel tension V4/伺服推杆/道雨传动 3000/TDN55三维图/TDN55三维图/TDN55折返/TDN55折返行程150/推荐电机/禾川400W不带刹车.SLDPRT
Peel tension V4/伺服推杆/道雨传动 3000/TDN55三维图/TDN55三维图/TDN55折返/TDN55折返行程150/推荐行星减速机/PLF60A单级模型（14-30 50-3 4-5.5-70）.SLDPRT
Peel tension V4/伺服推杆/道雨传动 3000/TDN55三维图/TDN55三维图/TDN55折返/TDN55折返行程150/电缸安装配件/2214899_DAMT-V1-40-A中间铰座.SLDPRT
Peel tension V4/伺服推杆/道雨传动 3000/TDN55三维图/TDN55三维图/TDN55折返/TDN55折返行程150/电缸安装配件/2214899_DAMT-V1-40-A中间铰座.STEP
Peel tension V4/伺服推杆/道雨传动 3000/TDN55三维图/TDN55三维图/TDN55折返/TDN55折返行程150/电缸安装配件/55折返后法兰安装板.SLDPRT
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
