xiangxu05/tensileMachine/Peel tension V4/伺服推杆/A伺服电缸 2850/后法兰安装图纸-YHX053-S150-D05-B-M4-C1-2-0400W-N1.pdf

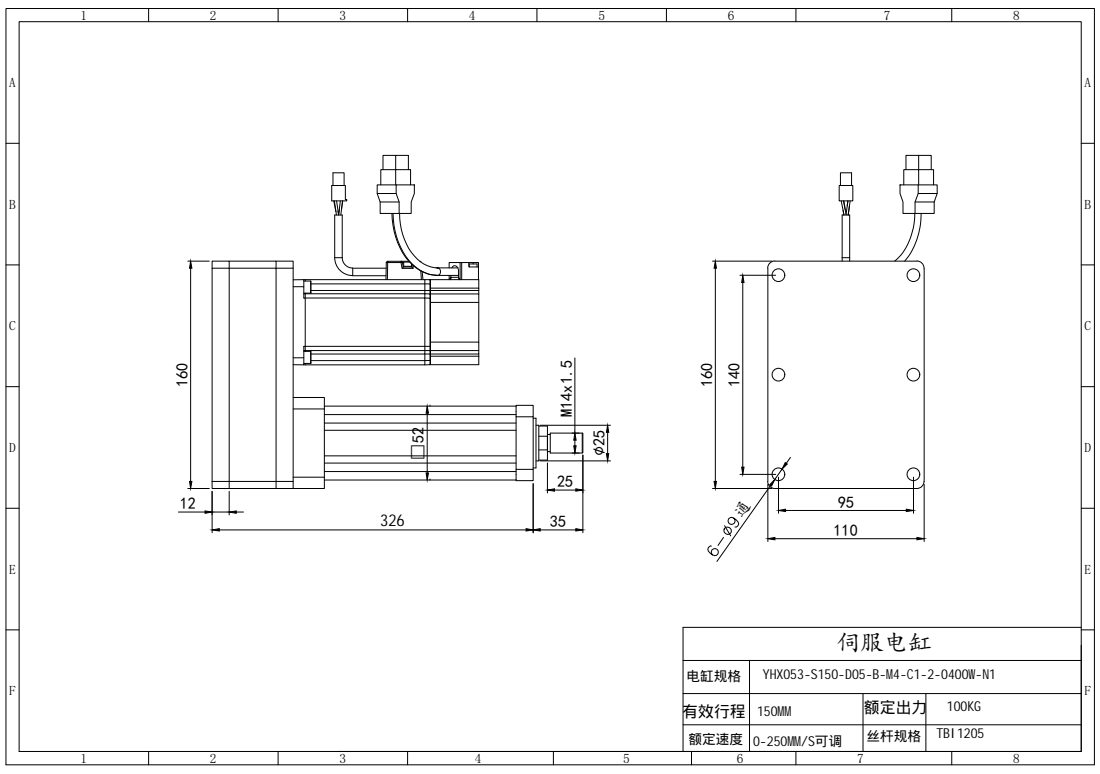
[picture p58: page 1]
M14x1.5 25 电缸规格 YHX053-S150-D05-B-M4-C1-2-0400W-N1

140 95 110 通 E A A 1 2 3 4 5 6 7 DCB EDCB 4 8 F 5 6 7 8 F 1 2 3 伺服电缸 有效行程 额定出力
