xiangxu05/tensileMachine/Peel tension V4/伺服推杆/伺服电动缸 2700/4_东菱DS2P-报警.pdf

10.3

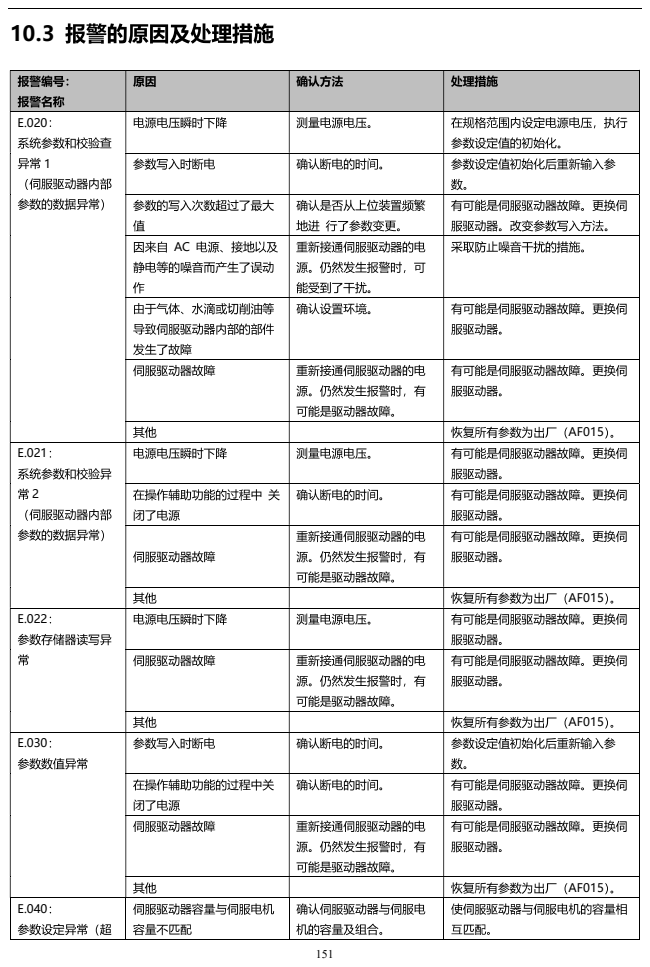
[picture p59: page 1]

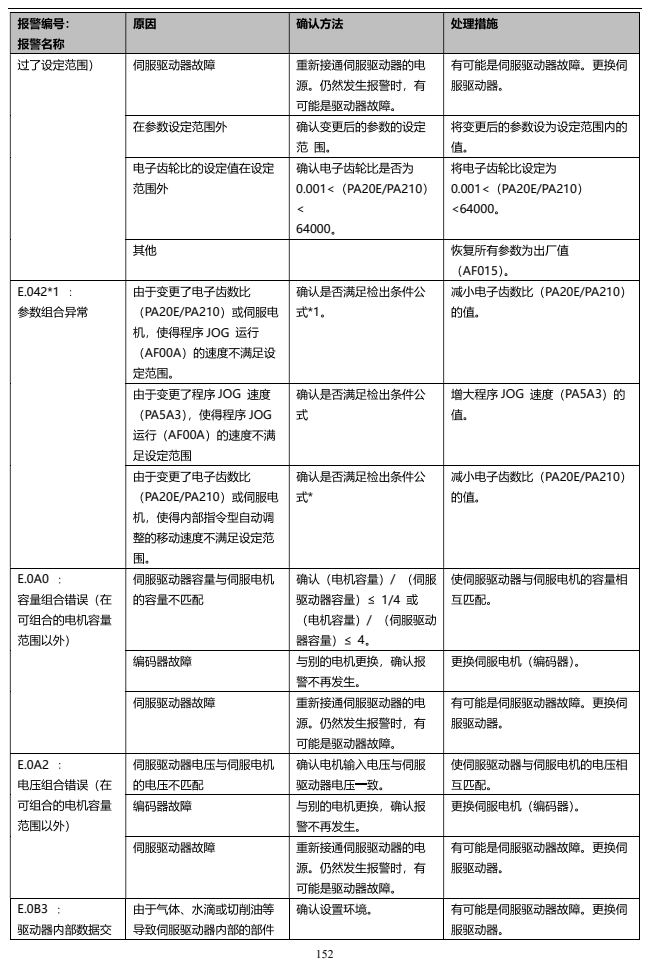
[picture p60: page 2]
JOG

E.042*1 | PA20E/PA210 JOG AF00A | *1 | PA20E/PA210

PA5A3 JOG AF00A | | JOG PA5A3

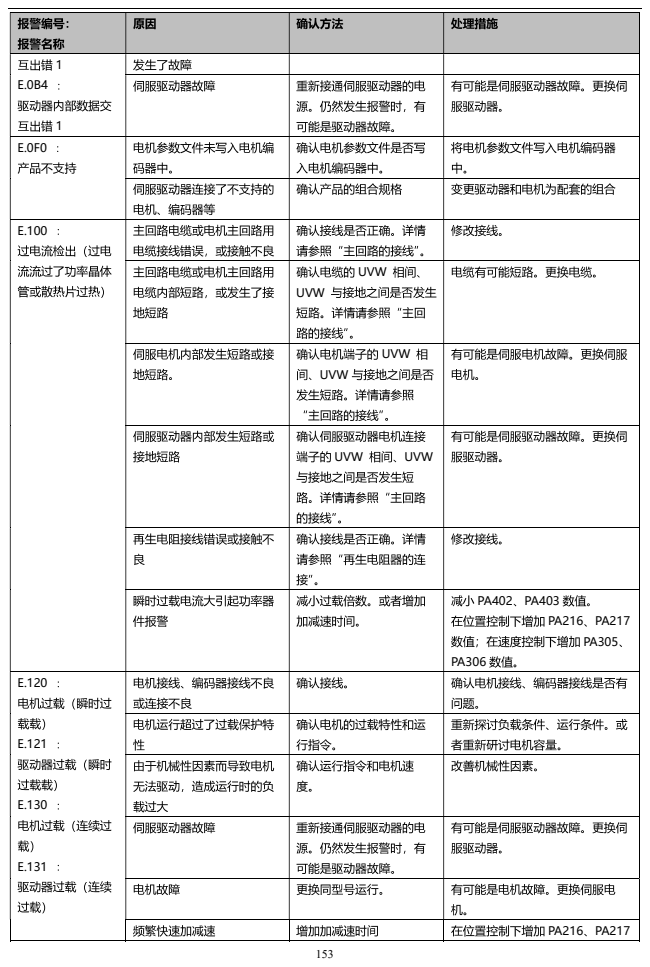
[picture p61: page 3]

UVW

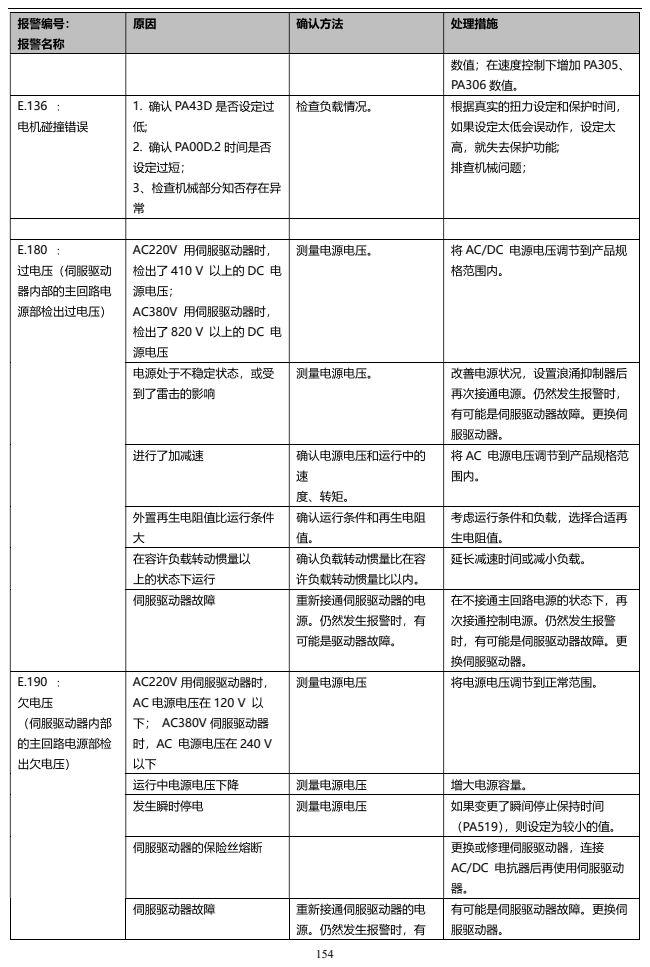
[picture p62: page 4]

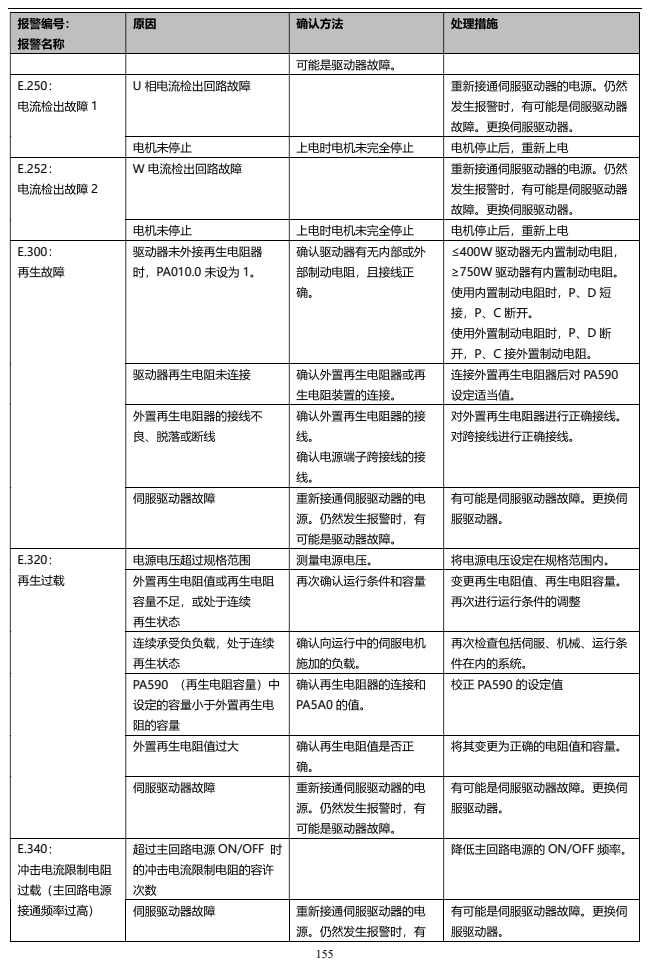
[picture p63: page 5]
ON/OFF

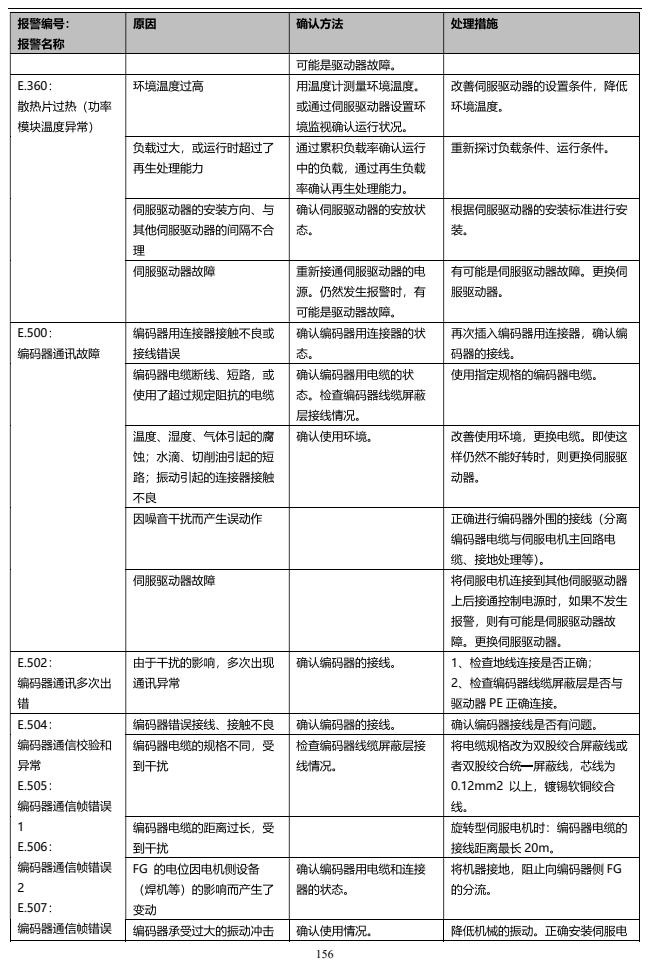
[picture p64: page 6]

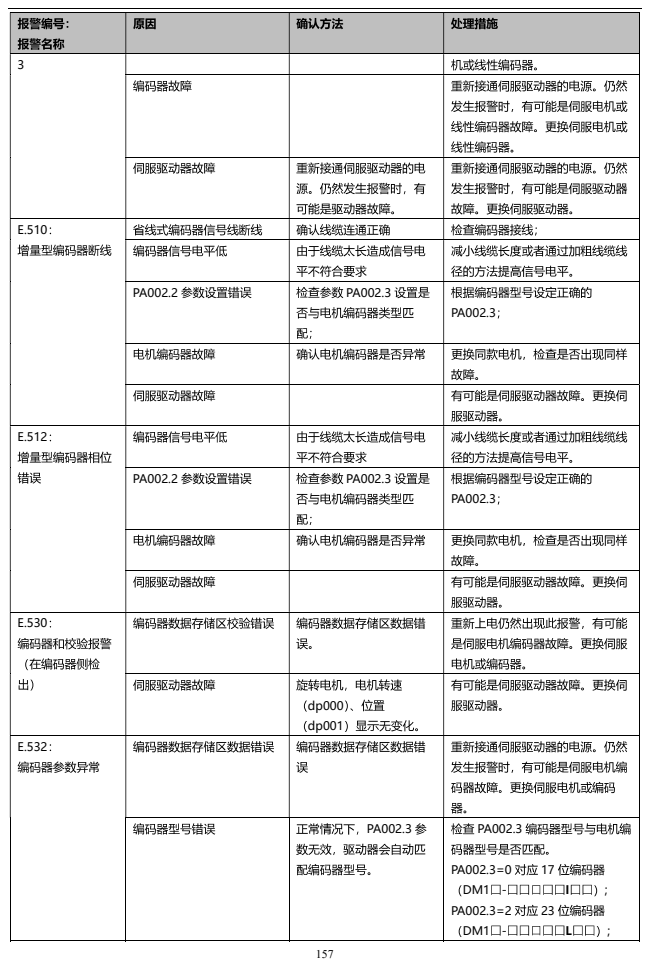
[picture p65: page 7]

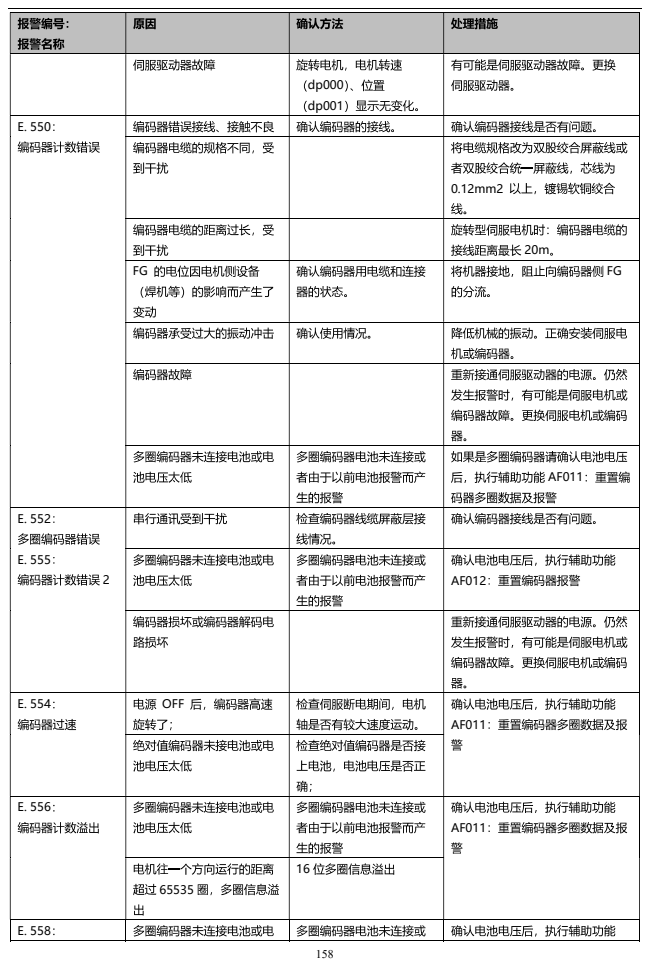
[picture p66: page 8]

E. 554 | OFF

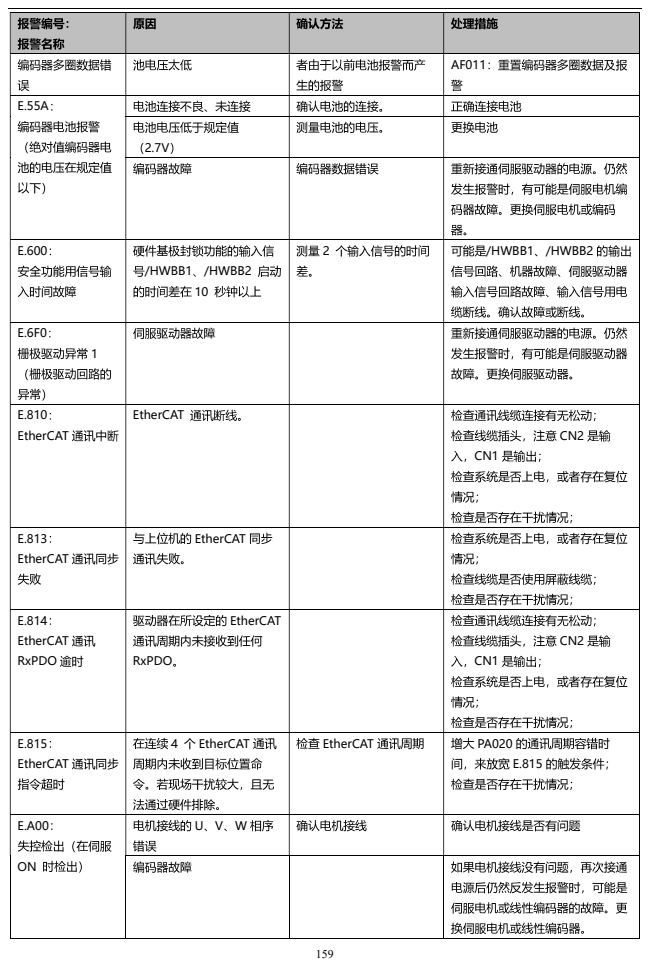
[picture p67: page 9]
EtherCAT

E.600 | /HWBB1 /HWBB2 | 2 /HWBB1 /HWBB2

E.810 | EtherCAT | | CN2 CN1

E.813 EtherCAT

E.814 EtherCAT RxPDO | EtherCAT RxPDO | | CN2 CN1

E.815 EtherCAT | 4 EtherCAT | EtherCAT | PA020 E.815

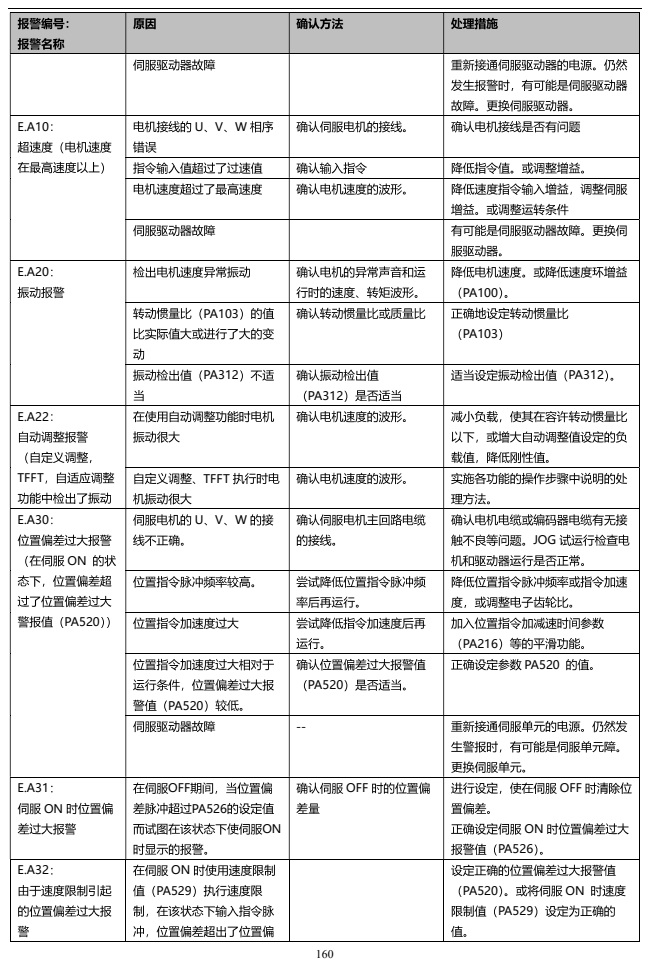
[picture p68: page 10]
OFF

E.A22 TFFT

TFFT

E.A30 ON PA520 | U V W | JOG

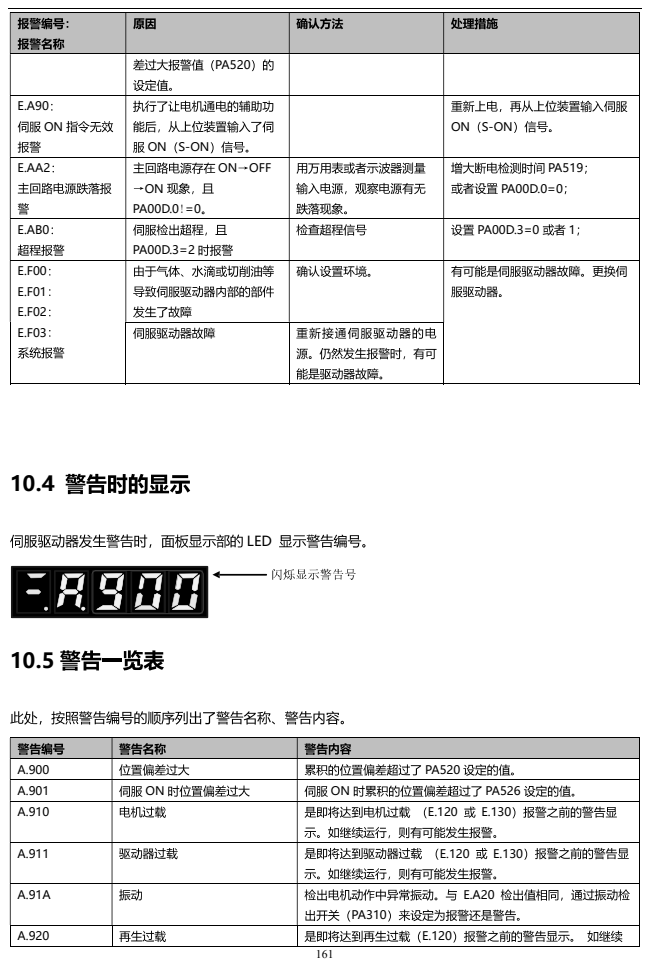
[picture p69: page 11]
ON OFF; LED
