xiangxu05/tensileMachine/(commit log)

2024-04-22 控制程序
2024-04-22 node-red程序
2024-04-22 Update README.md
    增加了对软件的说明
2024-04-22 拉力机建模
    [2214899_DAMT-V1-40-A中间铰座.SLDPRT, 2214899_DAMT-V1-40-A中间铰座.STEP, 400W.STEP.SLDPRT, 40x40x160 横梁.SLDPRT, 40x40x260 纵梁.SLDPRT, 53-QFL.STEP.SLDPRT, 53GT.STEP.SLDPRT, 53HFL.STEP.SLDPRT]
